scrapcomputing/ThrottleBlaster/(threads)

Thread 1 (2024-04-07):

LEDC68 Display Compatibility

skadarnold, 2024-04-07:
Thank you for your work on this, I am very excited to give it a try.

I don't see myself having as much use for a 4 digit display, and I have a couple of LEDC68's around from some gotek floppy drives.

https://github.com/coopzone-dc/GotekLEDC68

It is based on the TM1651 so I wonder if it would be compatible without any modification. I plan to give a try when I have everything built, but I thought I might bring it to your attention.

scrapcomputing, 2024-04-07:
This is the exact display I used in the first video :) It works, but not as well as the 4-digit TM1637: (i)  the display won't show the rightmost digit, and (ii) it shows some erroneous dots.

To fix issue (i) you can build the firmware  using the additional configuration: `-DDISPLAY_SHIFT_LEFT=1` in `cmake -DDISPLAY_SHIFT_LEFT=1 -DCMAKE_BUILD_TYPE=Release -DPICO_SDK_PATH=/path/to/pico-sdk/ ../src/`. Please try the attached firmware, which is based on rev.0.3 and is configured with this option.

I am not sure how to fix issue (ii), as I am relying on a third-party library for driving the display, and I couldn't figure out how to fix it.
[ThrottleBlaster_rev0.3_3digit_TM1651.uf2.zip](https://github.com/scrapcomputing/ThrottleBlaster/files/14898361/ThrottleBlaster_rev0.3_3digit_TM1651.uf2.zip)

skadarnold, 2024-04-07:
Aha I see in your video now. Thank you for the information, I might play around with some of the code and see if I can work some of that out. The 3 digit display could work particularly well for a certain case that I have if I can find a good way to mount it.

PCB's are on their way now, but had to reorder with 0.3 update because I want to use UART. Really cool!

scrapcomputing, 2024-04-07:
Feel free to send over any patches if you manage to fix the issues.

Yeah, mounting the displays is a bit tricky, we may need a custom PCB for some of the common ones.

skadarnold, 2024-04-28:
For some reason I am stuck on building this on Windows 11. The cmake command successfully generates the configuration and it looks good, but when I run make I get "make:  *** No targets specified and no makefile found.  Stop.". I will keep playing around.

scrapcomputing, 2024-06-11:
This error message means that `Makefile` is not found in the current directory.
Are you still having this issue, or should I close the ticket?

skadarnold, 2024-06-11:
I was not able to get this to work unfortunately, but it is probably something on my end and with windows. I will have to give this a try with linux.

Feel free to close the ticket and I will open a new issue when I have some time to work on this a bit more. Thanks for checking!

Closed 2024-06-13.

Thread 2 (2024-04-08):

Checking on some parts for BOM

skadarnold, 2024-04-08:
After watching todays video I wanted to recommend this molex connector I discovered that works well for floppy drive power. It has the indent to help restrict plugging it in incorrectly.

Molex 22-05-3041
https://www.mouser.com/ProductDetail/538-22-05-3041

I have a question about the rotary encoder that was used in your last video. I see that it has the rivets for mounting it with a bolt, is this the EC11 with a knurled shaft?

https://www.mouser.com/ProductDetail/Alps-Alpine/EC1110120201-with-knurled-SHAFT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

skadarnold, 2024-04-08:
I am realizing that Molex 22-05-3041 may be inverted because the friction lock is on the top of the connector which would maybe force the floppy power to be inserted upside down.

Closed 2024-04-09.

Thread 3 (2024-04-09):

Mounting Ideas

skadarnold, 2024-04-09:
I have been thinking of different ways to conveniently mount and control the ThrottleBlaster and I thought I might share some ideas.

I ordered a few of these PCI brackets with predrilled holes for wifi antenna's
[PCI Brackets](https://www.aliexpress.us/item/3256805155324104.html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
)
In previous projects I have found these wifi antenna holes to be a perfect size for things like 3.5mm audio jacks and bolt mounted buttons. I was thinking it might work well to mount two buttons and a potentiometer so that you had access to control from the back.

Originally I was thinking it might work well to used the knurled rotary encoder to bolt through one of the antenna holes which would also mount the pcb and pico with it all in one, but I don't think it would work all that well with this current design. Maybe a redesign where the rotary could be at a 90 degree angle and the pico and board were angled in a way to be flush with the pci slot could be a good option though.

scrapcomputing, 2024-04-09:
Thanks for sharing your ideas. Good to know that these wifi card brackets have such conveniently sized hole!

Yeah, I think the current board is a bit too wide. But you can always mount it on the side and use some wires to connect the rotary encoder to the board, like you do on a gotek. I don't think that rotary encoders with 90 degree mounts are widely available.
The header for the potentiometer is on the side, so you might be able to mount it on the PCB.

Closed 2024-04-26.

Thread 4 (2024-04-12):

Rotary Encoder

oXL0C0Xo, 2024-04-12:
Hi, I have a question about what type of rotary encoder to use. Sorry for my lack of knowledge about them, but when I look up the part number "EC11E" on mouser, quite a few options come up with different attributes. Do you have a suggested part number that is best for this? Any help would be appreciated. Thanks again!

scrapcomputing, 2024-04-13:
As far as I know any 5-pin rotary encoder (3-pins for the rotary circuit and 2 for the push-button) with the same footprint should do. There are a lot of variants, the main difference being the type of knob they can accommodate. So you will have to choose one according to the knob you are planning to get.
"Alps EC11E" is the footprint I used for the PCB, but should fit most common rotary encoders of that pinout and size. The ones I used in my build are some very cheap clones I got in a kit, I think 5 or 6 of them along with their knobs. You can easily find such inexpensive kits online.

Closed 2024-04-26.

Thread 5 (2024-04-24):

MAX3232 Footprint

skadarnold, 2024-04-24:
My PCB's have finally arrived, but it seems that the IC I chose for the MAX3232 seems to be too wide. I should have looked at the specs a little closer, but I also had some confusion as to what I should be looking for. Example in the PCB layout with kicad it says it is an SOIC-16W, but it states the width at 5.3mm. Not only is SOIC-16W way too wide to even consider, but even the closest thing I can find is a SOIC-16 narrow which is 4mm wide. Most of the SOIC-16 options are around 7mm which is what I originally tried hoping the pads would line up just enough.

Also the SOIC-16 narrow ones that may work are $7 a piece in comparison to $2. Not sure if it is really worth it at that point or not.

scrapcomputing, 2024-04-25:
That's a bummer!

The one I am using is a Ti MAX3232EC which I got locally for about $1.50. This package type is actually pretty common. If you check on Digikey these parts are listed as "16-SOIC 3.90mm width" in the Package/Case column, and the most affordable one is at $1.49 (model: MAX3232ECDR).
Digikey's measurement refers to the IC's package width, which is indeed 3.90mm. Kicad's measurement refers to the gap between the pads on the PCB, which is 5.30mm.

Thanks for letting me know about this, I will add a note in the BOM explaining this a bit further.
I hope you find the right part at an affordable price! Oh, and stay away of the really cheap unbranded ones, as most of them are fake chips that either don't work right away, or stop working soon after.

skadarnold, 2024-04-25:
Ok great thank you! The MAX3232EC is one that I was looking at as well since it is listed at mouser as 3.91mm width. This helps confirm this will work even though the listing specs it as SOIC-16 narrow. I had noticed in your video that the IC you used seemed slightly narrow so I thought I would take the chance with the a regular SOIC-16. I will get the new ones order and thankfully I can solder them in at a later date and build the rest for current testing.

Closed 2024-04-26.

Thread 6 (2024-04-25):

Output Noise

skadarnold, 2024-04-25:
Hello,
I was able to build my first 0.3 throttleblaster last night and everything was pretty straight forward. This morning I decided to test the output with the oscilloscope to make sure it was behaving properly before connecting it to CPU socket. The PWM seems to be behaving properly, but the line seems very noisy and unstable. There is a very strong peak on the waveform as well that makes be think it could use some filtering in general. This seems incorrect but I am not sure what is going on yet. I have checked for solder bridges and R1 and R2 are measuring in spec. I will keep you in touch but let me know if you have any suggestions.

This happens in all modes, 1but, rot, and pot as well so I do not think it is an input / control issue.

https://github.com/scrapcomputing/ThrottleBlaster/assets/80274795/b9738cd5-4f8d-4a0b-8ba2-52d2adc0d4e0

skadarnold, 2024-04-25:
The signal looks clean up until the MOSFET so I am going to look at that and maybe swap it out.

skadarnold, 2024-04-25:
I have swapped the MOSFET out and also tried pulling the R2 just to make sure it wasn't causing some weirdness but the problem still persists. I am thinking that things are not happy with that type of 2N7000 I used.

scrapcomputing, 2024-04-26:
You can't really measure the signal at the output pin (Q1) because the MOSFET is only pulling down the STPCLK pin, which has an internal pull up. So measuring noise at the output is expected behavior.
If you really want to measure something at the output try adding a 1K resistor to 3.3 or 5V, otherwise just measure at the MOSFET's gate.

skadarnold, 2024-04-26:
Ahh ok I see now, I was starting to wonder if this behavior was normal. Thank you for clarifying. I will give it a go with a CPU then!

Closed 2024-04-26.

Thread 7 (2024-04-26):

VGA port ripple current

skadarnold, 2024-04-26:
Hello again,
I have good news of success, my throttle blaster is functioning properly with a socket 7 233MMX! Very exciting to see the computer slow down to a stop with such fine control. I did want to mention that there is a slight ripple that becomes visible on my LED display as PWM is active. My graphics card is onboard motherboard so it could be situational. It is slight, but it creates a sort of wavey distortion especially across text. I will  play around with it when I have some time tomorrow.

skadarnold, 2024-04-26:
I think a lot of this is being caused by a lower quality PSU being used as my test computer. This visual distortion does not happen on my CRT.  Not sure if this is something that can be helped in the design of throttle blaster or not.

scrapcomputing, 2024-04-27:
This is quite strange. Is this distortion visible at all Throttle Blaster frequencies?

skadarnold, 2024-04-27:
Yes it is visible whenever PWM is modulating. Example if the potentiometer is all the way open it is clear, if it is all the way closed it goes away, everything else in between modulates as distortion and seems to change slightly through frequency changes. I will try to provide a video when I have a moment.

skadarnold, 2024-04-27:
Unfortunately my attempts to capture the distortion didn't work out all that well. It is easy to see with the eyes but subtle in a way.   I can also hear an oscillation happening inside of the PSU, so it could also be poor filtration there as well. It reminds me of like a coil whine from a bad fan or something like that.

scrapcomputing, 2024-04-27:
Makes sense, perhaps you could try measuring the 5V rail voltage, if that shows some ripple, then perhaps this is indeed a PSU issue.

skadarnold, 2024-04-27:
Yes you are correct. I am able to measure the ripple on the 5v line. It is probably a good idea that I replace this cheap PSU.

skadarnold, 2024-04-27:
I just tried a VGA cable with a ferrite bead and it cleared up the visual distortions. It may just be a better cable and not the bead but it definitely seems to have fixed the issue.

The PSU whine and dirty 5v is still present aside from that though.

skadarnold, 2024-04-27:
This can be closed, but the issue is good for awareness.

Closed 2024-04-27.

Thread 8 (2024-04-26):

DB9 Concept Design

skadarnold, 2024-04-26:
I have been spending some time thinking of good mounting options, and I had some ideas I decided to crudely draw out that would utilize simple DB9 PCI mounting brackets like the ones shown here..
https://www.amazon.com/gp/product/B008635ANK/ref=ppx_yo_dt_b_search_asin_title?ie=UTF8&psc=1
The idea is the top ribbon DB9 would be removed then the throttle blaster could be designed to have a DB9 for direct mounting to the bracket. The DB9 could also be utilized as a pinout to send 5v, display, rotary / button combos with a simple PCB designed just for these few components. The rotary / button controls could also be combined into a ribbon cable to attach to PCB's designed for internal control like a front panel as well. Then instead of having 3 pins for RS232 connection, maybe just provide a ribbon cable connection that can slide right on to a motherboard or serial controller header and also provide a through connection for the bottom DB9 ribbon.  Of course fill in any gaps on the PCB for all the throttle blaster components and other internal headers that are needed.
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

If I have the time I might try to prototype something like this. I have limited experience with kicad but I might play around with it this idea.

scrapcomputing, 2024-04-27:
Yeah, that could be a good option for controlling it via the serial port. The current design is more suitable for a 5.25 panel like this: https://www.youtube.com/shorts/n1aFvRNtOcw

skadarnold, 2024-04-27:
That is a great design as well!

skadarnold, 2024-04-27:
I think this can be closed. But wanted to put some ideas out there!

Closed 2024-04-27.

Thread 9 (2024-04-28):

StpClk 0.1mm wire success

skadarnold, 2024-04-28:
I was able to use the throttle blaster using 0.1mm enameled wire at the stpclk pin under the CPU. Originally I was testing with 30 gauge but I feel like that is too tight of a fit and felt weird in socket. The 0.1mm can hardly be noticed when inserting the CPU which is good, but can also be tricky to hold steady. I think maybe a little thicker might be the sweet spot for this.

https://www.amazon.com/gp/product/B08ZMP5GXD/ref=ppx_yo_dt_b_search_asin_title?ie=UTF8&psc=1
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

I used a bit of kapton tape to keep a little slack near the socket.

scrapcomputing, 2024-06-11:
Awesome, thanks for sharing the photo!

Closed 2024-06-11.

Thread 10 (2024-05-10):

Question about slotket adapter

TheMLGladiator, 2024-05-10:
I have a slot 1 to socket 370 adapter. Does it matter if I connect the STPCLK# wire to the pin on the motherboard or the pin on the slotket?

scrapcomputing, 2024-05-11:
I checked on my slotket and there is continuity between pins B6 (slot 1) and AG35 (Socket 370). So it shouldn't matter either way.

Closed 2024-06-08.

Thread 11 (2024-05-21):

Remote control / KVM

opualuan, 2024-05-21:
I have several systems going through KVM, I don’t have easy access to the tower to make adjustments. It would be great to have a MHz display and knob at my desk and run a small cable to the PC. Appreciate your ideas on how to extend this without causing noise on the stpclk pin- maybe a second pico in the remote box talking to the one in the pc?

scrapcomputing, 2024-05-21:
Hmm if I were you I would use a UTP cat5 cable (the one used for Ethernet network cables that contains 8 small wires). The display needs 4 cables, one of which is ground, and the rotary encoder needs 5, 2 of which are ground (see the schematic: https://github.com/scrapcomputing/ThrottleBlaster/blob/main/img/ThrottleBlaster.svg). Ground is common across these, so you actually only need 7 wires to carry the signals over. I would use 4 wires for the display and another 4 for the rotary (pins A,C,B and S1).

I hope this helps :)

opualuan, 2024-05-21:
That’s a great breakdown of the signals, cat5 is convenient. I’ll give it a shot, thanks!

scrapcomputing, 2024-05-23:
Another alternative would be to keep the Throttle Blaster on your desk with a long STPCLK cable, but you would also need to power the Throttle Blaster from the PC because both need to have the same ground. I don't think that the STPCLK cable needs to be very short. The frequency of the STPCLK signal is quite low so it should still work with a long cable. Another alternative would be to use a coaxial cable, something like an RG58 should work I guess, this should protect from any noise.

Closed 2024-06-08.

Thread 12 (2024-06-05):

Should modifications to the presets get saved and persist through a power cycle?

Therrixxe, 2024-06-05:
I make a change to a preset and then power cycle the machine and it appears to revert back to the stock value. The CPU max frequency is being saved. I tried it on 3 different machines

scrapcomputing, 2024-06-06:
Thank you for reporting the bug! Yes, the should be saved. I fixed the issue in revision 0.6. Please try out the new firmware version and let me know if you have any more issues. Thanks again :)

Therrixxe, 2024-06-06:
Thank you for the quick fix. Works great now and I also tested out the reverse direction by soldering in a jumper wire ... works perfectly as well. Would it be possible to use the extra GPIO pin on the pico to have buttons that would jump to presets? I was thinking about making a front panel that would have buttons for XT - 4 AT - 8 ,286 10, 386 25, 486 33, Pentium 66. It wouldn't need a new board I could just solder the pin headers to the pico. Thanks again.

scrapcomputing, 2024-06-07:
That's a great idea! Please use the latest firmware (rev 0.7). You can connect the buttons to GPIOs 10,11,12,13,18,19,20,21 and they will select the presets in order (4MHz, 8MHz, etc). GPIO 21 will always switch to the maximum frequency. I have also updated the PCB, just in case :)

Closed 2024-06-08.

Thread 13 (2024-06-07):

Preset buttons change the LED display however speed doesn't get applied.

Therrixxe, 2024-06-07:
When the preset button is pressed the display is changed however the new speed doesn't take effect.

scrapcomputing, 2024-06-08:
Oops! I have updated the rev 0.7 firmware file in the releases. Please try that one.
Thanks!

Therrixxe, 2024-06-08:
It applies the settings now however it appear to jump to the value 4 8 10 25 33 66 133 etc not the modified preset.

scrapcomputing, 2024-06-08:
Thanks once again for spotting the bug. It should be fixed now. Please try the latest rev 0.7 firmware file. Thanks!

Therrixxe, 2024-06-09:
That fixed it. Working great now thanks again!

Closed 2024-06-11.

Thread 14 (2024-06-07):

Feature request: Reset button using remaining GPIO pins

Therrixxe, 2024-06-07:
Would it be possible to run the reset button from the computer case to the throttleblaster and then from the throttleblaster to the motherboard. When the reset button is pressed it will go to max frequency and then 20 seconds or so later go back to the frequency it was at before the reset button was pressed?

Currently whenever I press the reset I set it back to stop otherwise it can take a very long time to complete the reboot.

scrapcomputing, 2024-06-08:
That's a great idea. Let me work on it and I'll get back to you.

scrapcomputing, 2024-06-11:
OK I think it's ready. This requires an additional 2N7000 transistor. Its source pin is connected to GP22 (for reset detection) and its gate pin to pin 36 for 3.3V, and its drain pin to the positive pin of Reset (see the schematic). The transistor acts as a level-shifter because the reset pin could be at 5V, while the Pico can only handle 3.3V. When you press the Reset button on your PC you are basically grounding the Reset + pin. This will pull down the transistor's source pin too, resulting in pulling down GP22. The firmware checks the state of GP22 and if it is being pulled down then it will set the frequency to Max for 20 seconds.

Please make sure you connect the reset header correctly (ground to ground and + to +), otherwise your PC will be in constant reset mode.
I have not done extensive testing, so please report any issues you may run into, and also let me know if you have any questions about the circuit.

Thanks!

Therrixxe, 2024-06-12:
Very cool can't wait to check it out. Soon as the parts show up I will give it a try. You reference RES1 and RES2 however the silk screens on the images you posted don't appear to be labeled. Looks like it doesn't matter which is plugged in as long as you get the polarity right ... it may cause some confusion though.

Therrixxe, 2024-06-12:
I see now that RES1 and RES2 is covered by the pin header in your image.

scrapcomputing, 2024-06-13:
Yeah, I will try to mark them differently in the next revision of the PCB. Thanks for the feedback.

willsy32, 2025-05-13:
I've been testing out the reset button for kicks.  It doesn't always work.  I'll see it do the countdown if I push the button really fast (or deliberately).  Could just be my motherboard.  i mostly run my games in windows 98 with the occasional DOS boot if I need it so it's not a super needed feature for me but figured I'd give some feedback. I'll eventually getting around to serial commands :)

Therrixxe, 2025-05-13:
> I've been testing out the reset button for kicks. It doesn't always work. I'll see it do the countdown if I push the button really fast (or deliberately). Could just be my motherboard. i mostly run my games in windows 98 with the occasional DOS boot if I need it so it's not a super needed feature for me but figured I'd give some feedback. I'll eventually getting around to serial commands :)

I haven't tried the reset button yet but I have used the serial commands quite a bit using LaunchBox for MS-DOS Special Edition 2. Prior to launching a speed sensitive game ( like Quest for Glory I ) it drops the frequency, launches the game and then executes again when the game is exited to return to full speed.

scrapcomputing, 2025-05-18:
@willsy32 thanks for reporting the issue, I will look into it soon.

kfix, 2025-05-23:
>  It doesn't always work. I'll see it do the countdown if I push the button really fast (or deliberately)

same experience for me (Tualeron socket370 440bx). the mosfet always does its job and relays the press to the motherboard, but the detection on the TB is flaky. I only get the boot countdown if press reset a few times in succession. holding it down for a single long press doesn't trigger the countdown.

willsy32, 2025-05-23:
> > It doesn't always work. I'll see it do the countdown if I push the button really fast (or deliberately)
>
> same experience for me (Tualeron socket370 440bx). the mosfet always does its job and relays the press to the motherboard, but the detection on the TB is flaky. I only get the boot countdown if press reset a few times in succession. holding it down for a single long press doesn't trigger the countdown.

It's the same experience for me and have a socket 1 440bx, your description fits much better and I realized that holding it long isn't what did it but pressing the button a few times

scrapcomputing, 2025-05-25:
This doesn't seem to be a firmware bug. I think it might be a circuit issue. The RESET signal is probably not getting propagated properly through the Q2 transistor. The job of that transistor is to protect the Pico from potentially getting 5V from the motherboard's reset when it's high (which could potentially be at 5V). But I think replacing the Q2 transistor with a diode (like a 1n4001, or any other diode) pin 1 -> pin 3 should do a similar job: the motherboard's 5V can't feed back into the RESET gpio because it's in reverse and when the motherboard's reset is grounded the diode is forward biased pulling down RESET.

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

kfix, 2025-05-28:
> But I think replacing the Q2 transistor with a diode (like a 1n4001, or any other diode) pin 1 -> pin 3 should do a similar job

the motherboard still resets (plugged into either header with correct polarity) but now I can't trigger the `boot` countdown at all using a [1N4148](https://www.vishay.com/docs/81857/1n4148.pdf)

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

scrapcomputing, 2025-05-29:
Thanks for trying this out.

Strange... Do you think you could measure the voltage at both sides of the diode with the reset switch in both positions (i.e., pressed and not-pressed) ?
Thanks!

kfix, 2025-05-29:
with common lead on the anode:
not-pressed: 0.25vdc
pressed: 0.03vdc

scrapcomputing, 2025-05-29:
Thanks for the measurements.

Could you also try with the pico powered on, the common lead of the multimeter connected to ground and the other lead connected to:
- cathode + reset not pushed
- cathode + reset pushed
- anode + reset not pushed
- anode + reset pushed

What I am trying to figure out is the voltage the motherboard provides on the reset pin on both states of the reset button and how that affects the pico-side too because the pico has a weak pull up, which could be too strong perhaps compared to the motherboard's pull-down when the button is pushed?

kfix, 2025-05-29:
with pico plugged and powered up

| point + condition | VDC |
| ----| ---- |
| cathode + reset not pushed | 5v |
| cathode + reset pushed | 0v |
| anode + reset not pushed | 3.2v |
| anode + reset pushed |  0.45v |

scrapcomputing, 2025-05-29:
Perfect, thanks for the measurements!

So the Pico's pin (connected to the anode) is at CMOS logic high when reset is not pushed and logic low when reset is pushed, just like what the firmware expects.
I would expect this to work hmm... not sure what is wrong.
If you have an extra Pico could you try replacing it just to rule out damaged GPIO pin?

Thanks!

scrapcomputing, 2025-05-31:
> That did the trick, thank you!

Great, thanks for trying out the firmware :)

> One issue with the feature is that if you press Reset again while the boot-countdown is in progress, the count doesn't start over.

That's a great point, please try the attached firmware.

[ThrottleBlaster_fixed_reset2.uf2.zip](https://github.com/user-attachments/files/20528334/ThrottleBlaster_fixed_reset2.uf2.zip)

kfix, 2025-05-31:
The new-new firmware works great, _UNLIMITED REBOOTS_!

Thanks @scrapcomputing, feels like I'm trying the new AI vibe coding craze😆

Thread 15 (2024-06-12):

Rotary encoder

oXL0C0Xo, 2024-06-12:
I'm wondering if these rotary encoders should work...
https://www.amazon.com/dp/B09KNC1J6H

Because I bought some of them, and when I rotate it, it does not switch the frequency reliably. So additionally I bought another type of encoder:
https://www.ebay.com/itm/164916234390

and this encoder has the same exact issue. What could I be doing wrong?

The encoder does change the frequency, but it seems like it takes a random amount of detents.

I appreciate your time.

Bryon

scrapcomputing, 2024-06-13:
My encoders work kind-of OK, they do skip some positions if rotated too quickly. I think they look like the ones in the amazon link. I have also noticed that using a knob actually helps.
This is a firmware issue that I will try to fix at some point.

scrapcomputing, 2024-11-20:
Firmware rev 0.8b should address the rotary encoder issue. Please give it a try when you get the chance.

Thread 16 (2024-07-03):

MAX3232 or MAX232?

oXL0C0Xo, 2024-07-03:
I know that the project calls for a MAX3232 which I did order, but the package size seems almost too small. I do have some MAX232 in stock, do you think these will be a compatible substitute? I might just try it to see if it works, was just wondering if you have before I spend a bunch of time soldering this up.

Thanks!

scrapcomputing, 2024-07-03:
I don't think the MAX232 will work because it is a 5V part. We are powering it with 3.3V so the MAX3232 is the right part.

oXL0C0Xo, 2024-07-03:
OK, thank you for letting me know!

Closed 2024-07-03.

Thread 17 (2024-09-26):

No effect when changing frequency

dbenoy, 2024-09-26:
My hardware: MSI MS5182 Socket 7 Motherboard, AMD K6/2-475

I'm getting no effect when I change the frequency. I'm new to electronics so bear with me :)

To verify the Throttle Blaster was working, I pulled up the STPCLK# output pin by connecting it with a 10k resistor to the display's VCC and examined it with an oscilloscope. The Throttle Blaster appeared to be pulling the signal low exactly as expected as I changed the frequency.

Also, when I connect the STPCLK# pin on the CPU to ground directly, the CPU pauses as expected.

I also set the clock speed all the way down to 0, and then measured between the STPCLK# output pin and ground and got roughly 100 ohms. I see that this should be expected because of the 100 ohm resistor. Oops. Should I not have been testing by connecting the CPU pin directly to ground like I did? Is that 100 ohm resistor required to prevent damage?

scrapcomputing, 2024-09-26:
The STPCLK# pin gets pulled down to the Throttle Blaster's ground by the transistor. Since you already checked that STPCLK# does work (with the help of the 10K pull-up resistor), the only thing that I can think of is that the Throttle Blaster's ground may not be the same as the PC's ground. This can happen if you are powering the Pico via USB using an external power adapter. If you use the Throttle Blaster's 4-pin power connector that shouldn't be an issue. In any case I would try connecting your PC's ground with the Throttle Blaster's ground using a piece of wire to see if this makes any difference.

dbenoy, 2024-09-26:
Yep I was powering it through the PC and got continuity between the Throttle Blaster ground and the PC ground.

I just tried testing it by connecting the CPU pin to ground through a 100ohm resistor, bypassing the Throttle Blaster entirely, and it didn't work. :sweat_smile: Direct connection still pauses the CPU, but going through a 100 ohm resistor doesn't. I measured the voltage between the CPU pin and ground and it drops to 1.7 volts which isn't low enough, yeah. Color me confused.

dbenoy, 2024-09-26:
(I may be out to lunch. New to electronics) My theory is that the internal pullup resistance on this CPU is somewhere in the neighborhood of 100 ohms, and so a 100 ohm resistor on the pin would divide the voltage by half and give the results I'm seeing. And I should try a lower resistance.

But I'm scared to do that without hearing what you think first :p

scrapcomputing, 2024-09-26:
This is very strange, 100 Ohms should be more than enough to pull down the STPCLK# pin. I am wondering whether it is the CPU itself that pulls it up hard or the motherboard. Could you please measure the resistance between the STPCLK# pin and VCC3 (or is it VCC2, can't remember) on the CPU with the CPU removed. I think the strong pull up should most probably be on the motherboard side, so it's probably also worth measuring the resistance on the socket with the CPU removed, and perhaps the voltage when it gets powered on?

Not sure it's safe to reduce the resistance, but if you really want to try it, add another 100 Ohm resistor in parallel, but it's probably best to try to understand what is causing the issue first.

dbenoy, 2024-09-26:
I'm getting like 10 megaohms between STPCLK# and the VCC3 and VCC2 pins. I tried switching the probes and it was some 5 megaohms. So basically no continuity?

dbenoy, 2024-09-26:
The voltage between STPCLK# and ground when the system is powered on is 3.27V, and I measured before that it only drops to 1.7V when it goes through a 100 ohm resistor.

When I short it to ground (and it pauses the CPU) through my multimeter, the current is less than a milliamp... which is not what I'd expect if the internal pullup was 100ohms .. hm. 3.3v / 100ohm = 33mA

dbenoy, 2024-09-26:
I wish the datasheet were more clear on exactly how much resistance to ground is too much according to its design. But I can't find anything to that effect.

dbenoy, 2024-09-26:
I pulled the CPU out as suggested. If it's connected to nothing at all on the motherboard then I imagine that would be a completely open connection.

But it isn't. I still get the 5Mohm reading between STPCLK# and ground and I can see like 0.5V in diode mode on my multimeter (I'm still not sure what I'm doing but I think that's indicating some kind of logic is connected there?)

I hit up the datasheets for the southbridge and it turns out it is connected to the STPCLK# pin:
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

... I guess that answers what's going on. The motherboard probably is pulling that pin high. Sad trombone for me.

scrapcomputing, 2024-09-27:
The chip is expected to control the STPCLK pin, but they would usually only pull it.

I think there are two ways to get it to work:
1. You can just try lowering the 100 Ohm resistor until it works. There is a chance that this will damage the chip but I would guess that there should be some protection against short circuits, so it might work just fine.
2. You can try cutting the trace that connects the motherboard's chip to the STPCLK# pin at the socket.

Closed 2024-09-26.

Thread 19 (2024-11-19):

Future changes question for potential redesign

RetroLoom, 2024-11-19:
Hey Scrap!

Now that I have been getting some experience with PCB design I have been venturing into different projects and planning out designs I have thought of over the years. I have had some ideas for changing the layout of the ThrottleBlaster for making a PCI bracket mounting revision. My 5.25" drive bays are full right now, and instead of switching them out I thought this would be a good option to have instead. I also have some ideas for bringing the display and control panel to an external module to sit on the desk connected via 9-pin d-sub connector or something similar. Not sure if I will do the control panel since I plan to mostly use the UART for control anyway, but it depends on how ambitious I get.

My main question is to ask if you have any future revision plans that I should be prepared to adjust to if I start making changes on my own fork? I don't mind adapting to small changes you might have in the PCB or schematic, but once I start modifying the layout of everything I am not sure how easy it will be to merge any new changes without dealing with conflicts. I feel like things are pretty settled on your end for this project, but I just thought I would check before diving in to deep.

Also, since I am also close to using up my PCI / ISA brackets at the moment I have also been considering combining the ThrottleBlaster into some other project ideas I have. Since the ThrottleBlaster takes up very little space, I might work to have it as a feature in an all in one card.

scrapcomputing, 2024-11-20:
Hi @skadarnold,
I don't have any plans for any major changes.
A pci version would be really nice, I remember some folks asking for such a variant.

skadarnold, 2024-11-26:
Here is a little sneak peak of what I am brewing up. Originally I thought it was going to be mounted to a PCI bracket, but I decided to move it to a full on ISA slot so it could include some other features as they develop.

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

I still have a ways to go with this before I test it out, but I think it is coming along. I will hold off on going over features other than the throttle blaster for now since they are still getting ironed out. But you can see the ThrottleBlaster section to the left. The idea the core of the ThrottleBlaster will be controlled via RS232, with the option to use an addon that connects with a DB9 type header. I also added two DB9 headers to attach to the MB serial headers, one to be used for input and the other for throughput so that it could still allow for a DSUB connector. The controller addon circuit is the same layout and size as the original ThrottleBlaster so that it could still mount into currently designed mounting, example like the 5.25" bay mounting kit. It also allows for the option to use the STPCLK pin in case it is to be mounted in a better position to the CPU. Also, I added a horizontal mounting EC11 rotary encoder so that it could easily be attached to a PCI bracket with a 1/4" hole. This is all optional since my main purpose is to control everything via serial, but it would be nice to be able to have tactile buttons and dials for this. Since the remote addon is connected via DB9 style header, I also plan to create a desktop control unit that can extend the DB9 connection with a standard serial cable.

scrapcomputing, 2024-12-12:
It looks really cool!

RetroLoom, 2025-01-31:
I haven't forgotten about this project but I am taking a few side steps in developing the main board. I have created this PWM to STPCLK module inspired by the Throttle Blaster.

[PWM2STPCLK Project](https://github.com/RetroLoom/PWM2STPCLK)

The idea is to make the throttling circuit compatible with any PWM controller and to have a secured position mounted in the computer. I plan on revising the Throttle Blaster to be compatible with this configuration as well. It can be set up using a PWM fan controller and connected with a  PWM fan cable as well.

I thought you might be interested in something like this as well.

scrapcomputing, 2025-02-06:
Nice! This looks awesome! I didn't know you could actually buy an off-the-shelf PWM module!

Sure please keep me updated with your latest design :)

RetroLoom, 2025-02-06:
> Nice! This looks awesome! I didn't know you could actually buy an off-the-shelf PWM module!
>
> Sure please keep me updated with your latest design :)

Thanks! This is the PWM fan controller I used in the demonstration photos.

[PWM Fan Controller](https://www.aliexpress.us/item/3256805787442361.html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)

I think you can find similar ones from amazon as well, but the Aliexpress ones are very inexpensive. I will update this on the readme as well.

I will keep you in touch!

RetroLoom, 2025-02-17:
I created an [issue](https://github.com/RetroLoom/PWM2STPCLK/issues/1) on my PWM2STPCLK repo that I wanted to mention to you here. I have noticed similar switching noise with the ThrottleBlaster and wouldn't mind exploring the reasons and possible solutions for it.

For isolating the grounds, I thought about replacing the 2N7002 with a [TLP175A photo-MOSFET](https://www.mouser.com/ProductDetail/Toshiba/TLP175ATPLE?qs=HVbQlW5zcXXp9ILK7hvmMw%3D%3D), but I have not worked with one before so I thought it would be good to have more minds on it.

Here is a sketch of a schematic I was thinking
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

Let me know what you think and thank you.

scrapcomputing, 2025-02-19:
Hmm could it be that the switching noise is from the long wire ? Perhaps if you replaced it with a coaxial cable instead it might reduce it ? I haven't noticed any such noise, though I haven't tried many sound cards.

RetroLoom, 2025-02-19:
I don't think it is coming from the long wire, but seems to originate from the PSU itself. I think it can be dependent on the quality of the ground traces / plane or even the the quality of the PSU so I don't know if it is a problem with all systems / configurations. I will try and do a little more testing to see if I can confirm. But so far in my research I have learned this can be common with fast switching. For an example even the pull-down from fast switching the voltage on the STPCLK pin can cause noise on certain PSU's or maybe even in the CPU itself. Or it could even be creating EMI that radiates from the CPU area. I am no expert and this is all mostly speculation but I thought I might explore the concept some more. If any of these conditions are true it seems the best solution is to ground the STPCLK pin directly to the chassis.

I will do some more testing and let you know what I discover.

RetroLoom, 2025-02-23:
I am still doing some research on this and plan to try in a different system to see if I have similar results. This system doesn't have a particularly nice PSU so it could be related to poor quality. When I get my  ear up to the noise it is definitely originating from the PSU. I decided to post a video so you can hear what I am talking about.

https://github.com/user-attachments/assets/737234e5-fb8f-4025-a86b-178b7385e801
You can hear when I click the PWM controller on the noise activates, then mellows out once I am at full on. It sort of reminds me of noisy dimmer light switches where the noise generates in between full dim to full brightness. This is using the PWM2STPCLK but I had similar noises when using the ThrottleBlaster. I had hoped mounting directly to the chassis might help mitigate some of this alone but apparently it didn't change much.

I don't know if it is radiating EMI from the CPU and it is being picked up by the PSU, or if it is back feeding through ground and oscillating circuits on the way, or something else. The radiating might be the most concerning if that is the case though.

RetroLoom, 2025-02-23:
I just tested this with my main system and it does not generate any noise. It does have a better quality PSU. While this is good news overall I still wonder if it is still worth exploring exactly what causes this oscillation in some configurations.

RetroLoom, 2025-04-13:
This thread can be closed. I will open the noise issue with a solution in a new thread.

Closed 2025-04-13.

Thread 20 (2025-01-09):

On motherboard with Socket 775 does not work

nahimov, 2025-01-09:
Hello! Could you help me understand why it doesn't work on socket 775? I use #STPCLK on Socket 775 pin "M3" but have no luck.

nahimov, 2025-01-09:
I think that we find how to solve this issue, we need some days for test.

scrapcomputing, 2025-01-10:
I have not tried it on a socket 775 system. I am interested to know whether it works.

nahimov, 2025-01-13:
Hello! It was launched on Anovo AIMB-865 (I865+ICH5). A 62ohm resistor (instead of 100 ohms) was used for operation. The system is working, but in speedsys, not one of the prepared profiles does not fit into the schedule. Too fast. Programs do not load with a pwm period below 17-19 (may it affect the operation of Pio mode?)
The encoder is unstable. The problem is with the profile mode, when setting the frequency or PWM, the control falls off. It does not respond to push or encoder turns in any way. The encoder itself is obviously worki

scrapcomputing, 2025-01-13:
- The 100 Ohm resistor at the STPCLK pin is just used for safety, but any lower value should also work.
- You can modify each preset to suit your needs. Just long push on it to adjust it. Regarding the pwm issue, it  may be related to the STPCLK resistor. Could you try a lower resistor value than 62 ohms, or perhaps bridge the resistor with a piece of wire so it's effectively 0 Ohms?
- This sounds like a firmware bug. Could you provide me with reproduction steps so I can fix it ? Thanks!

nahimov, 2025-01-13:
The encoder works fine until you go into editing presets.
1. Select any of the ready-made profiles and press the long push on the encoder.
2. Select the desired MHZ (Pre) and press the push button to confirm.
3. Select the desired PWM (Per) and press the push button to confirm.

After selecting PWM (Per) and pressing the encoder button, it may freeze in several ways:
* Freezes at the last selected PWM value, there is no reaction from the encoder. The numbers on the screen
keep blinking. (you have to reboot ThrottleBlaster)
* Freezes after the done message appears, and again there is no reaction from the encoder.
(you have to restart ThrottleBlaster)

We need some days for testing...

scrapcomputing, 2025-01-20:
Thanks for the detailed bug report. I fixed the firmware bug. Please upgrade the firmware to the latest release: Rev 0.8c.

nahimov, 2025-01-29:
Hi! First of all, thank you for latest firmware.

About problem on socket 775

During testing, there were big problems with the disk subsystem (IDE and SATA). Any decrease in frequency immediately fails. Pin M3 is responsible for the operation of STPCLK. Tracking where it goes to the south bridge and isolating it from the south bridge did not give a positive result, apparently the signals to the south bridge also go through other pins. Everything was tested on ICH5 (Intel 82801EB). When using an external controller, everything is working normally. I think this problem will also be on socket 478. We checked on two different boards, all of which had this south bridge.

The verdict:

1. The operation of the Trottblaster negatively affects the operation of the integrated disk subsystem.
2. The operation of the Trottblaster will be stable if you use an external disk controller.

scrapcomputing, 2025-02-06:
Thanks for the update.

I am curious, how did you attach a wire to the STPCLK pin? Isn't socket 775 surface mounted?

nahimov, 2025-02-07:
Hi! First of all... Nope :-)

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

And second, we finded contact who go to southbridge on our motherboard

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

nahimov, 2025-02-07:
Anyway you can find this pin by use multitester and find near south bridge

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

Also we do it on another motherboard 775i65G

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

scrapcomputing, 2025-04-07:
All you need to do is change the entries of `const std::vector<Entry> ImmutableTable` in `src/Presets.h`  and rebuild.

I built one (attached), though I don't have time to test it right now. But I think it should work. Let me know if it doesn't.

[ThrottleBlaster_4.77_12_40_133_max.uf2.zip](https://github.com/user-attachments/files/19634351/ThrottleBlaster_4.77_12_40_133_max.uf2.zip)

nahimov, 2025-04-08:
Thank you very much! I will try.

filthyfreak, 2025-05-01:
Hi @nahimov

I plan on setting up TB on my socket 478 which has the same Intel 82801EB (ICH5).

Which external storage controller are you using and how are you booting into it?

nahimov, 2025-05-29:
Hi @filthyfreak
Sorry for delay. It doesn't matter which controller. I used the regular promise ata 100 ide. In Bios you have menu for boot from controller.

nahimov, 2025-05-29:
By the way, if anyone is interested, I did this on Tualatin-s.

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

nahimov, 2025-06-21:
@Peckmore Hi! Right now I can't. I try at next month. This files on another pc. But you have to understand that I made it for a specific screen and specific buttons I bought.
p.s. It's very strange, but no one had noticed this panel before. Just like no one pays attention to my implementation of the panel for mt32-pi, which is higher in the photo. I tried to choose a screen that looked as much like the original mt-32 as possible....

nahimov, 2025-06-21:
@scrapcomputing Hello, my friend! I found one problem. I bought a second pi for a different throttle and what can I say. The 0.8c version of the software works well on the left pi in the photo (dark green), but not on the right pi (fake Chinese, as I understand it) because I can't save the frequency, but the older 0.8b version works well on this device. :-) Did I understand correctly that this can be fixed in version 0.8d, and both pi will be able to work properly?

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

scrapcomputing, 2025-06-21:
Hi @nahimov
- 0.8d fixes an issue related to reset detection. So if you are not using that feature then this release shouldn't fix your issue, but you could try it. Please let me know if this doesn't work on the clone.
- 0.8c fixes a crash that would hang the ThrottleBlaster when you would try to save the frequency (introduced in 0.8b). Hmm I am not sure why this wouldn't work on a clone.
- 0.8b contains a bug that crashes the TB which is why I removed it from the repo, but if you think that one worked fine here it is (attached)

[ThrottleBlaster_0.8b.uf2.zip](https://github.com/user-attachments/files/20847542/ThrottleBlaster_0.8b.uf2.zip)

nahimov, 2025-06-22:
@scrapcomputing Yes, I'll post them when I can, both of them (for mt32 and for trottle on another PC). But you need to understand that they were made for certain screens and buttons that I bought on Aliexpress. Do I need to post links to screens and buttons? 0.8b on the clone set the frequency. 0.8c on the original set frenquency, I don't know why that is 🤷🏻

scrapcomputing, 2025-06-22:
@nahimov Using your specific buttons is perfectly fine. Just please make sure you share the sources of the design (not just the STL file) in case others want to make small modifications to suit their buttons or to accommodate future ThrottleBlaster PCBs that may not fit the current one.

I don't think links for screens and buttons are necessary (though that would be nice), but some close-up photos and perhaps some search keywords would be super helpful.

nahimov, 2025-06-30:
@Peckmore @scrapcomputing Hello!

[throttle.zip](https://github.com/user-attachments/files/20976616/throttle.zip)

[mt32-pi.zip](https://github.com/user-attachments/files/20976619/mt32-pi.zip)

I don't know you can or not buy from Aliexpress at your country.

screen for throttle - https://aliexpress.ru/item/1005008137384657.html

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

button for throttle - https://aliexpress.ru/item/1005007560430185.html

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

screen for mt-32pi - https://www.aliexpress.ru/item/1005006632495660.html

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

driver for screen - https://www.aliexpress.ru/item/1005006086057327.html

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

button for mt-32pi - https://aliexpress.ru/item/1005006689494738.html

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

One moment. Because screen is big I used separate power supply cable. So SDA and SCL I used from mt-32pi but power external (As an option from the floppy drive, you can use). On button I used all from mt32-pi and power also.

nahimov, 2025-06-30:
A lot of old motherboards from the time of pentium 2 and pentium 3 have an IrDA connector, the TTL level is used there, I tried to make the trottle control work through it, but unfortunately nothing worked. As it is, it would be great not to solder to the com port.

scrapcomputing, 2025-06-30:
@nahimov thanks for sharing photos and links :)

As for your IrDA question, I am not familiar with the IrDA connector protocol but I can look into it.
- What software are you using from the PC side to talk to it ?
- Also since it's TTL it would require level shifting on the Pico side in place of the MAX3232 (which is not TTL). How did you connect the IrDA port to the Throttle Blaster?

nahimov, 2025-06-30:
@scrapcomputing I'll try to use kermit. I solder pins to picopi not to max232 ofcourse. On motherboards wehave pins for IrDa and in bios we can set use IrDa and IrDa are set address from com1 or com2 (3F8 or 2F8). So as I can understand after it we can use IrDa like UART and if we solder to pins on picopi it must start work, but have no luck, I havent Oscillograph, maybe we can use some kind of resistors to match the signal.

p.s. did you see two archives with panels ?

scrapcomputing, 2025-07-01:
I don't think kermit will work. It expects a UART, not sure the interface of the IrDa chip but if it's not UART it is unlikely to work.

Hmm why can't you just plug in to the COM pins on the motherboard? Most motherboards should have those, no need for soldering.

> p.s. did you see two archives with panels ?

I haven't checked them out yet. But you seem to have done some great work, why don't you create a github page to show it off ?

nahimov, 2025-07-01:
About github, I don't have anything else interesting, so I probably won't :-)

What about IrDa. That's what Artificial Intelligence told me: "Yes, IrDA (Infrared Data Association) SIR (Serial Infrared) mode relies on a UART (Universal Asynchronous Receiver/Transmitter) for its physical layer. IrDA SIR uses the same data framing as RS-232, which is typically handled by a UART. The Uart serial data stream is then encoded and decoded by an IrDA encoder/decoder (ENDEC) module before being transmitted via infrared light."

I tried connecting from my laptop via usb - uart on PuTTY and listen, But I didn't catch anything.

About plug in to the COM pins. We can do this only on older board like AT, on ATX it's hard to use, because COM ports on back plate pannel. On my PC, which I showed above, I soldered to the connector.

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

Unfortunately, my knowledge is not enough to understand and deal with this. Of course, I understand that if you don't have time for this, it's not a big problem, but this connection may be useful for some other projects in the future.

p.s. By the way, my friend, what do you think about the zuluide project? This is the first CD rom ide emulation project with the Possibility to use the red book, i.e. bin/cue that play through the audio output. It's a very interesting thing, the software is publicly available, but the hardware part is expensive, it seems to me that it can be implemented in a cheaper version on a picopi and not with a SD card, but with a converter to CF or SSD on SATA if you have very much images of cd.

scrapcomputing, 2025-10-04:
@nahimov Thanks for sharing your success with the Pentium pro! I will certainly update the page, but could I ask you to share 2 photos, one from the socket side and one from the back. Ideally I would like them to be taken from a similar angle as the photos of the other sockets listed in the main page.

Regarding talking to IrDA, this looks very interesting. If there is a library for the pico that implements the protocol we could easily plug it in.

nahimov, 2025-10-04:
@scrapcomputing good?

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

scrapcomputing, 2025-10-04:
@nahimov these look great, thanks! I will crop them a bit and will include them. Oh by the way, what license are you sharing them under ? or should we treat them as "public domain" ?

Regarding the usb-c pico clone, I was not aware that these were not powering the throttle blaster! The actual throttling should still work as it's powered by the pico's 3.3v output. The 7-segment display is getting powered by the VSYS pin, so perhaps they have not connected that? Strange.

nahimov, 2025-10-04:
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

nahimov, 2025-10-05:
@scrapcomputing I found another one written in C, not Python. Just for an appointment. In general, this is exactly what we are interested in, because there is nothing to transmit from the trottleblaster, we need to send it to it. https://github.com/kazkojima/pico-irda

Thread 21 (2025-04-13):

Frequency oscillation with some PSUs

RetroLoom, 2025-04-13:
On at least one of my computer builds noise is generated when using the ThrottleBlaster and PWM2STPCLK devices. I have mentioned this on other issue threads but I decided to have a dedicated one since finding a solution. When using a more customizable PWM generator I learned that the noise directly correlates to the PWM frequency. This makes sense because you can actually use PWM as a tone generator this way. I found setting the frequency to 60-100hz was able to create a frequency that was naturally filtered or too low for my PSU. With non extensive testing I found that this does not affect the behavior of the PWM or throttling so could possibly be used as a default.

Here are some videos demonstrating the affect of changing the frequency the pitch shifting along with the changes.

https://github.com/user-attachments/assets/7e597425-c28a-471a-9160-4fe78ae61327
This first video starts at around 9.5khz and cycles down. There are certain cycles that can be heard more clearly than others.

https://github.com/user-attachments/assets/38fa0ce3-84d7-4164-8444-17187c4e585b

scrapcomputing, 2025-04-19:
Thanks for looking into this! Lowering the PWM frequency to < 100 Hz seems to be a good way of getting rid of the noise. Not sure what the threshold is before we start running into issues though. Have you tried very low frequencies, like 10Hz ?

Thread 22 (2025-05-09):

Slot 1 Pentium3 800mhz not working

willsy32, 2025-05-09:
Soldered to a via that connects to B6 on my pentium 3.  Nothing seems to work and I think it's because the trace doesn't go straight to the cpu but instead through a voltage translator "GTL2000DL" (https://www.nxp.com/part/GTL2000DL).  I assume I'll need to connect directly to the back of the cpu, but can't find a schematic (hard to follow the trace).  I can provide more pics if needed (back of cpu is provided), and would love any help I can get. Thanks!

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

scrapcomputing, 2025-05-09:
I don't think the level shifter would be an issue. It's job is to translate 3.3V motherboard-based signals down to ~1.5V for the CPU and vice versa. The throttle blaster would still pull down the 3.3V STPCLK# signal to zero on the motherboard side and that should still generate the corresponding pulses from ~1.5V down to zero on the CPU side.

The first thing I would check is whether there is continuity between the ground of the Throttle Blaster and that of the CPU. This means that there should be a wire connecting the ground of the Throttle Blaster and the ground of the motherboard or the PC case chassis. Without it the circuit won't work.

If this doesn't solve the problem, you couldmeasure the voltage at B6 with a multimeter. It should normally be high (3.3V or higher) when the Throttle Blaster is disconnected or when set at the maximum "frequency" setting. Dialing it down should decrease the average voltage level, bringing it almost down to 0 at the lowest setting.

Finally you could try soldering the wire to the low-voltage section of the level-shifter. It should be the pin on the opposite side if I am reading the datasheet for the GTL2000 correctly. But I doubt that would solve the issue.

I hope this helps, let me know if you are still having issues with it.

Thanks!

willsy32, 2025-05-09:
I'm grabbing ground from my psu and just have my floppy power connector connected directly to my throttle blaster.  Ill check the voltage to see if it's being pulled down, I appreciate the help!

willsy32, 2025-05-10:
Ok, so I reflowed all of the solder joints and then tested the voltages.  At 800mhz it's at 2.5 volts and at its lowest it's at approximately 0.8 volts.  Haven't done any benchmarks or anything yet since I took out my PC to the workbench, but I'm happy it's doing what it's doing something.  For some reason though at 25mhz it's at 0.84 volts so not sure if it's scaling right or not

willsy32, 2025-05-10:
I haven't tested any bench marks because I don't have a monitor where I'm at, but I want to confirm if those values are good or bad before I move forward

scrapcomputing, 2025-05-10:
I think the voltages sound reasonable.

The easiest way to test it is with the DOS benchmark pack from philscomputerlab.

willsy32, 2025-05-10:
Great, I'll test in the morning!

willsy32, 2025-05-10:
Yeah, the bios isn't posting....

willsy32, 2025-05-10:
After testing a few benchmarks and confirming the voltage being pulled to 0.8. I am not seeing any slowdowns in the every benchmark test from philscomplab dosbenchmark pack

willsy32, 2025-05-10:
I am not seeing any slowdowns (even minor) when pulling 2.5volts to 0.8volts.  I've tested all of the philscomplab benchmarks and tested 800mhz and 0mhz

scrapcomputing, 2025-05-10:
Ah great you got it working!

Strange, the slowdown should be more or less linear. One thing you could try is to reduce the value of the R2 resistor at the output transistor from 100 Ohms to perhaps half (e.g. by soldering another 100Ohm resistor in parallel). The resistor is there mainly for safety, to avoid pulling down the STPCLK pin too hard. But an average value of 0.8V at 4MHz is probably a bit higher than expected (even though measuring with a multimeter is not accurate), so perhaps the signal is not pulled down as hard as it should.

I hope this helps.

willsy32, 2025-05-11:
This may have done it.  I got this throttle blaster pack from an eBay seller and didn't double check the values on the actual resistor.  Seems R2 has been 1000 ohms all along.  I'll

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

willsy32, 2025-05-11:
Lol not easy to do. Almost gave up to try 47 ohm instead XD

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

willsy32, 2025-05-11:
And it works!!!!!!

willsy32, 2025-05-11:
Works absolutely amazing too.  Super happy to finally get this project done with :)

scrapcomputing, 2025-05-11:
That's great! Happy throttling :)

As for the accuracy you can fine-tune each preset by changing the actual frequency (not the displayed one) and its PWM period (see the state diagrams at the project's page).

47 Ohms should work too. You could also stack the 100 Ohm resistors on top of each other, it might be easier to solder that way.
Btw I will add a note about the resistor value at the project's page. Thanks for helping with troubleshooting :)

Closed 2025-05-11.
