scrapcomputing/ThrottleBlaster/(commit log)

2024-03-24 Rev.0.2: New 2-Btn operation
    [ThrottleBlaster.kicad_pcb, ThrottleBlaster.sch]
2024-03-24 Rev.0.3 Uart
    [ThrottleBlaster.kicad_pcb, ThrottleBlaster.sch]
